NickB1/balboa-spa-mqtt-controller/README.md

# balboa-spa-mqtt-controller
 Balboa Spa MQTT Controller on NodeMCU
