NickB1/balboa-spa-mqtt-controller/nodemcu_settings.png

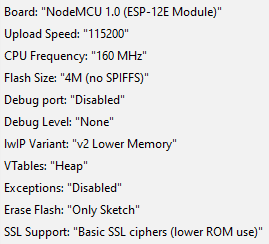
nodemcu_settings.png
