NickB1/balboa-spa-mqtt-controller/hardware/balboa-spa-mqtt-controller.pdf

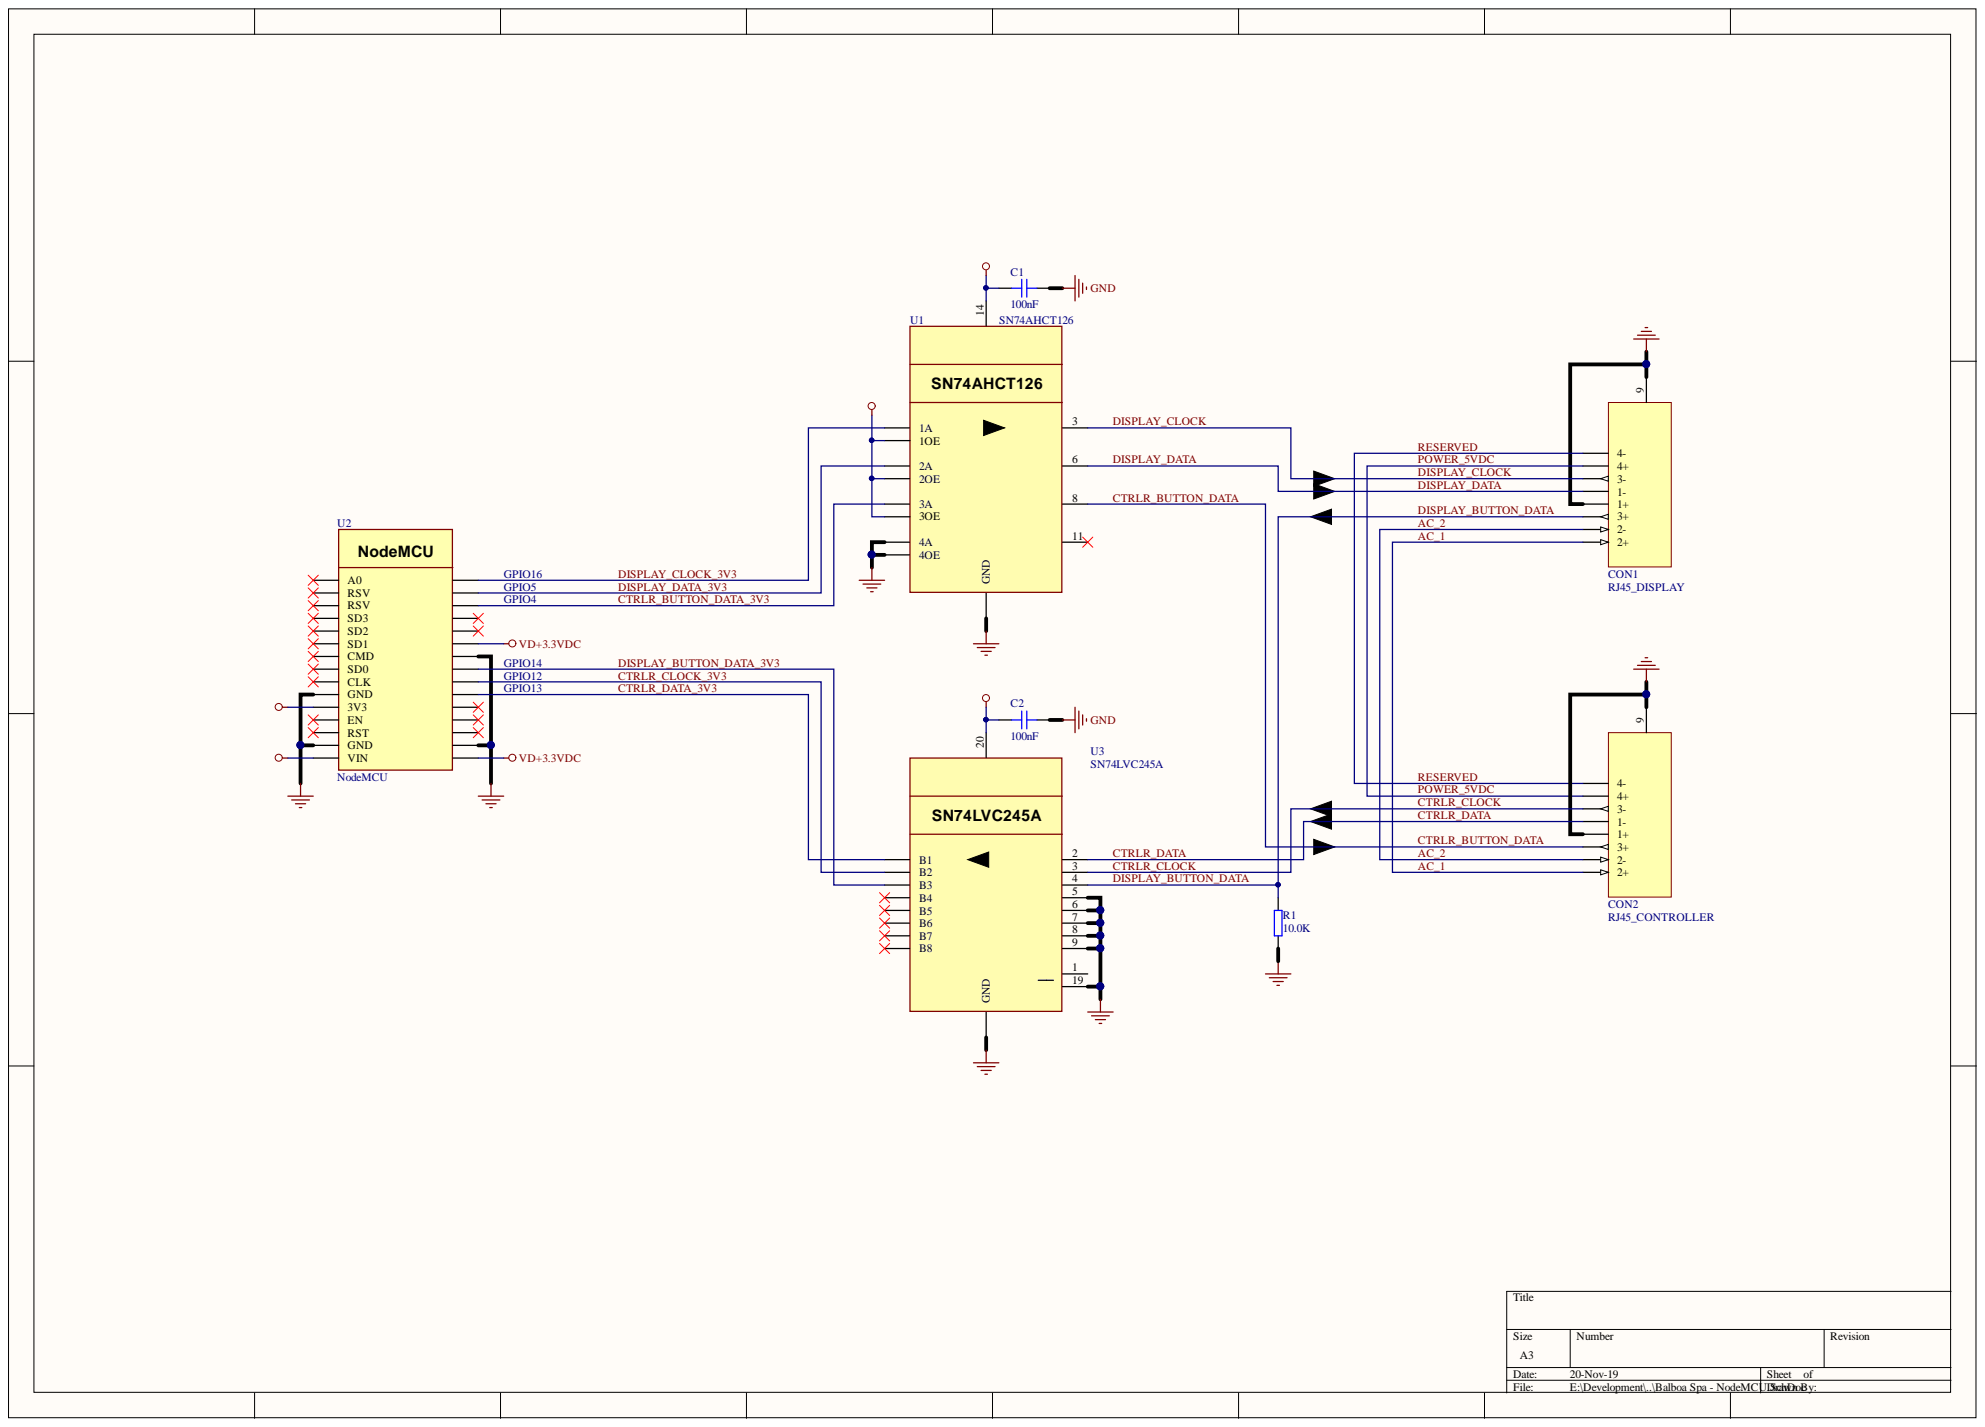
[picture p2: page 1]

P OWE R _ 5 V D C

D I S P L AY _D ATA

1 1 | D I S P L AY _B U T T O N _D ATA | 3 + 2 -2 +

G P I O 5 D I S P L AY _D ATA _ 3 V 3
G P I O 4 C T R L R _B U T T O N _D ATA _ 3 V 3

G P I O 1 2 C T R L R _ C L O C K _ 3 V 3
G P I O 1 3 C T R L R _D ATA _ 3 V 3

C T R L R _D ATA

C T R L R _B U T T O N _D ATA

C T R L R _D ATA | | A C _ 2

3 | C T R L R _ C L O C K | A C _ 1
4 | D I S P L AY _B U T T O N _D ATA

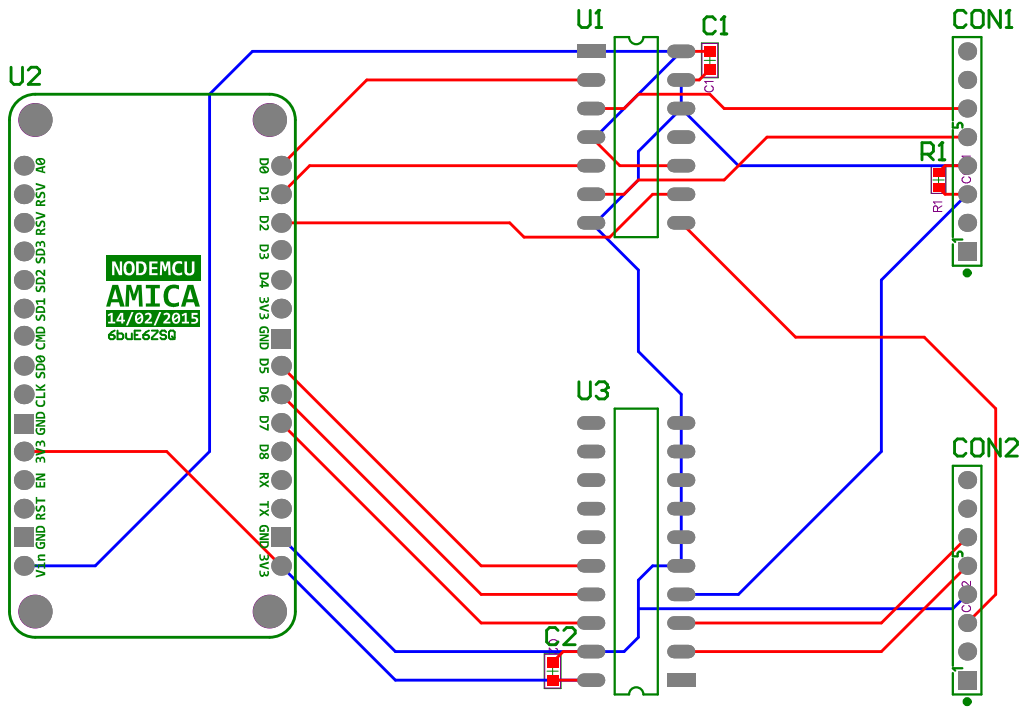
[picture p3: page 2]
