NickB1/balboa-spa-mqtt-controller/(threads)

Thread 2 (2020-11-20):

Query: interface with Balboa PCB

EmmanuelLM, 2020-11-20:
Hi Nick, I am planning to create a version of your system and was a little confused as to the interface of your system.
Am I right in thinking that it sits between the PCB and the display?
Is the connection out to the display compulsory given the more recent PCBs have two display/wifi connectors?

I am thinking that your system could be a good way to replace the (very expensive) Balboa Wifi system

NickB1, 2020-11-20:
Hi,

Yes the interface sits in between the controller and the display.
My controller was fairly old, so your mileage may vary on the display protocol being the same.
I also wrote seperate functions for parsing the controller data en sending data to the display.
The controller parser was trigged by clock interrupts, the display function was free running.
I can remember the ESP sometimes missing clock pulses from the controller, I had to add some error checking to circumvent this.

I think a better/simpler approuch would be to just connect the controller and display together while also connecting the signals to the ESP.
And then let the ESP do button presses to alter settings.
You might have to use an OR gate on the button signal line to not get any conflicts between the display and the ESP.

My controller began to show more problem and I eventually built a controller from scratch which can still interface with the original display: https://github.com/NickB1/OpenSpa

EmmanuelLM, 2020-11-20:
Thank you Nick, very helpful

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

altontoth, 2021-06-14:
Hi Nick. I spent the day trying to sniff traffic and meter out connections on my Balboa hot tub. Finally decided to pull the control pad apart, and discovered there's a whole other microprocessor in there, and everything is done over serial interface. The pinouts look to be a LOT more like what you have going on than other projects I've found online.  I'm just wondering how the NodeMCU worked for you in this application, acting in between devices. I was initially thinking of splitting the cable off into a Y to allow me to interface the MCU in parallel with the keypad, but I realized this project might be a little too deep for me. Until I saw you implementation here. I have the PPW700 main board with the 33363 topside controls (6 button with display, RJ45 connection).

Thread 3 (2021-08-10):

Getting a reboot / connection error

altontoth, 2021-08-10:
Getting the following ESP error. No concept of where I need to go to fit it. Thoughts?

Decoding stack results
0x40203a64: Adafruit_MQTT_Publish::publish(int) at .....\Arduino\libraries\Adafruit_MQTT_Library\Adafruit_MQTT.cpp line 904
0x4020183a: balboa_display_poll() at .....\balboa-spa-mqtt-controller-master\balboa-spa-mqtt-controller-master\balboa-spa-mqtt-controller/balboa-interface.ino line 485
0x40202348: loop() at .....\balboa-spa-mqtt-controller-master\balboa-spa-mqtt-controller-master\balboa-spa-mqtt-controller/balboa-spa-mqtt-controller.ino line 35
0x40205068: loop_wrapper() at .....Arduino15\packages\esp8266\hardware\esp8266\3.0.1\cores\esp8266\core_esp8266_main.cpp line 201

NickB1, 2021-08-11:
Hi,

I just tested the code with the latest version of the ESP8266 core (3.0.2) and the Adafruit MQTT library (2.4.2) and it seems to run without rebooting.
Could you give this a try?

NickB1, 2021-08-11:
Also made a new commit, fixed some warnings coming up with the new ESP8266 core.

altontoth, 2021-08-11:
Thanks, I'll have a bit of a deeper dive on it tonight. I found that with some careful commenting and serial printing, I isolated the crash to the "balboa_display_comm" function. Once I comment out the contents of the function, the code works just fine, including integration with AdafruitIO. I've even added a couple more values that I felt were missing for feedback (nothing better than learning by breaking other people's code).

To be fair, I am trying to get the system running crash free out of the hot tub environment before I plug it into my hot tub, so I don't know if that lack of tub connection is causing a problem. I just built the circuit up on perf board for the time being.

altontoth, 2021-08-12:
Whatever was going on, I copied your code cleanup from today, and realized that I only had 3.0.1 installed on the ESP core. Was already running the latest AdafruitIO library. Seems to be no errors! Going to try plugging it back in to the hot tub tomorrow. Had a display freakout, and some other issues. But that was before I discovered the reboot loop. Hopefully I built your circuit correctly.

Just so you know, over on my fork I included an extra bit of data, to publish the desired temperature, to provide feedback back to the MQTT based interface. Are you running your own broker? Was there anything specific you needed to do to get it running? I'm not a big fan of 'cloud', so I am slowly building up an Ubuntu based OpenHab (+ other things) setup.

NickB1, 2021-08-12:
Ok great, let me know how it goes. It's not my best/cleanest work but it worked :D.
Thanks for continuing work on the code.
I'm indeed running my own Mosquitto broker next to OpenHAB (both running on a raspberry pi), setup is fairly easy.
